Chuck-Wang/Age-of-Ultrasound/README.md

# Age-of-Ultrasound
Our challenge is to develop a device to standardize the process of capturing and sending ultrasound data using smartphones for remote diagnostics and digital record in low resource countries.
