Chuck-Wang/Age-of-Ultrasound/CAD Models/framespv2.stl

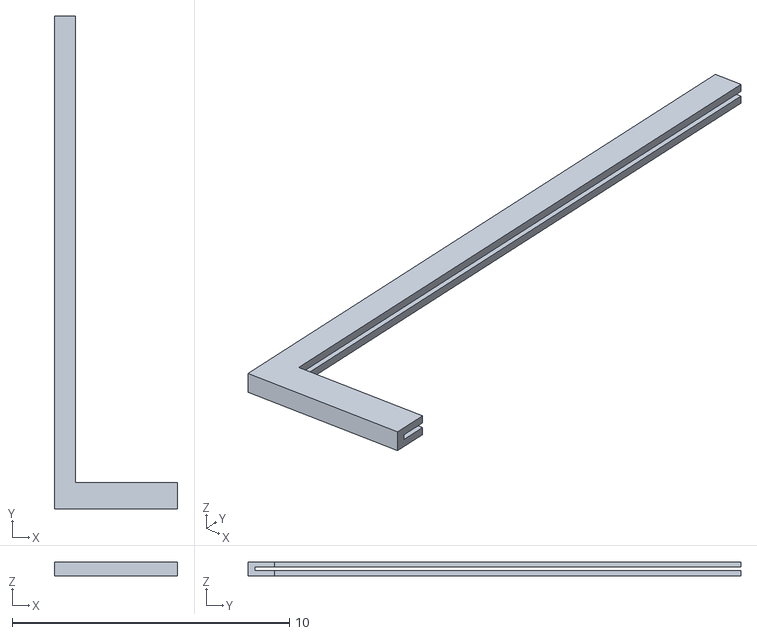
[picture p33: CAD file, 2017-11-28]
CAD Models/framespv2.stl
4.45 x 17.8 x 0.508
