Chuck-Wang/Age-of-Ultrasound/CAD Models/fixforbroken2.stl

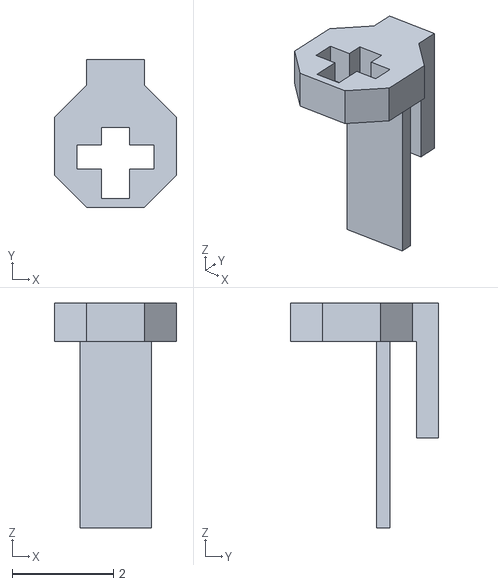
[picture p34: CAD file, 2017-11-28]
CAD Models/fixforbroken2.stl
2.41 x 2.92 x 4.44
