Chuck-Wang/Age-of-Ultrasound/CAD Models/horizontalclamppiece.stl

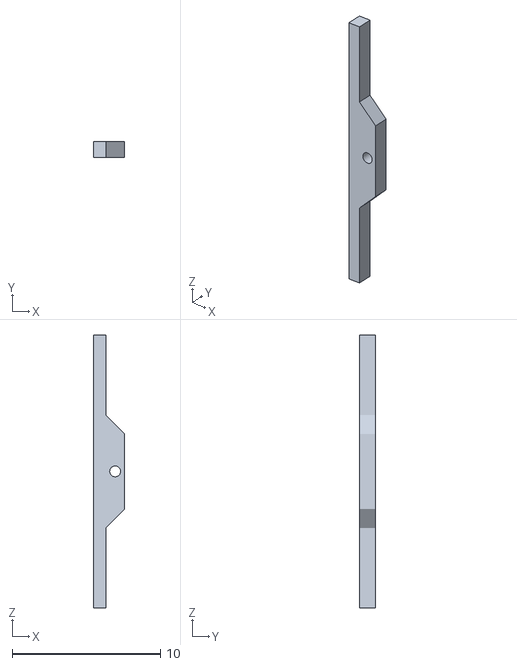
[picture p35: CAD file, 2017-11-28]
CAD Models/horizontalclamppiece.stl
2.11 x 1.07 x 18.4
