Chuck-Wang/Age-of-Ultrasound/CAD Models/horzntalconnection.stl

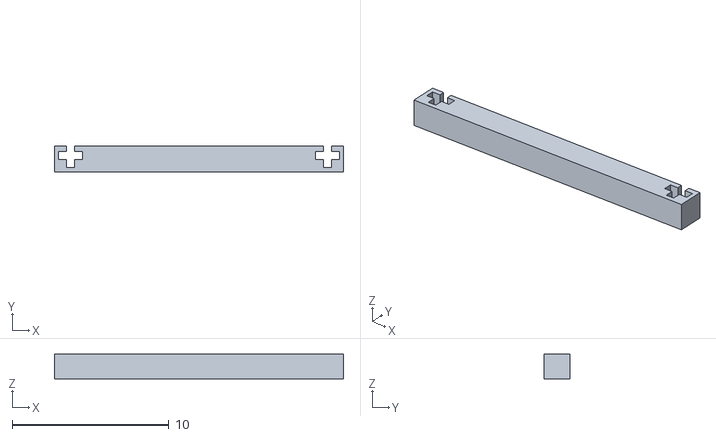
[picture p36: CAD file, 2017-11-28]
CAD Models/horzntalconnection.stl
18.4 x 1.64 x 1.59
