Chuck-Wang/Age-of-Ultrasound/CAD Models/RIPnewslideholder3.stl

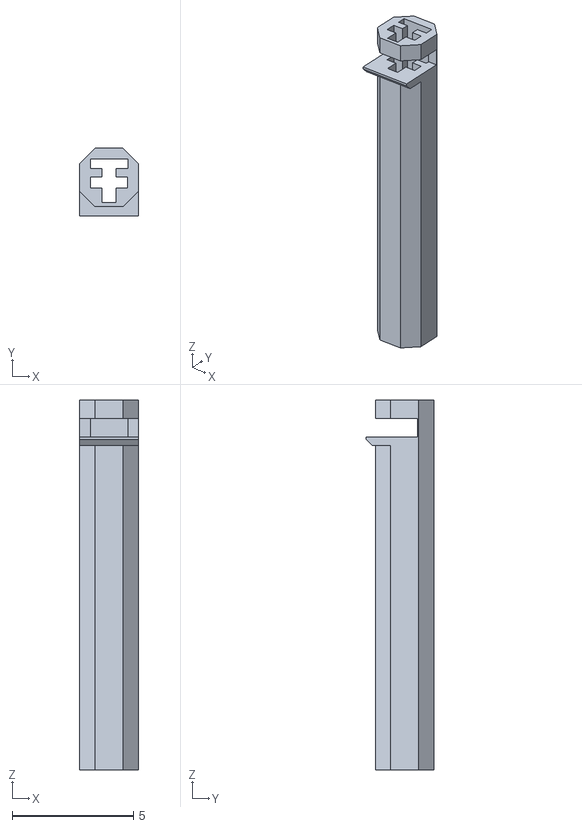
[picture p37: CAD file, 2017-11-28]
CAD Models/RIPnewslideholder3.stl
2.41 x 2.79 x 15.2
