Chuck-Wang/Age-of-Ultrasound/CAD Models/RIPnewslide3.stl

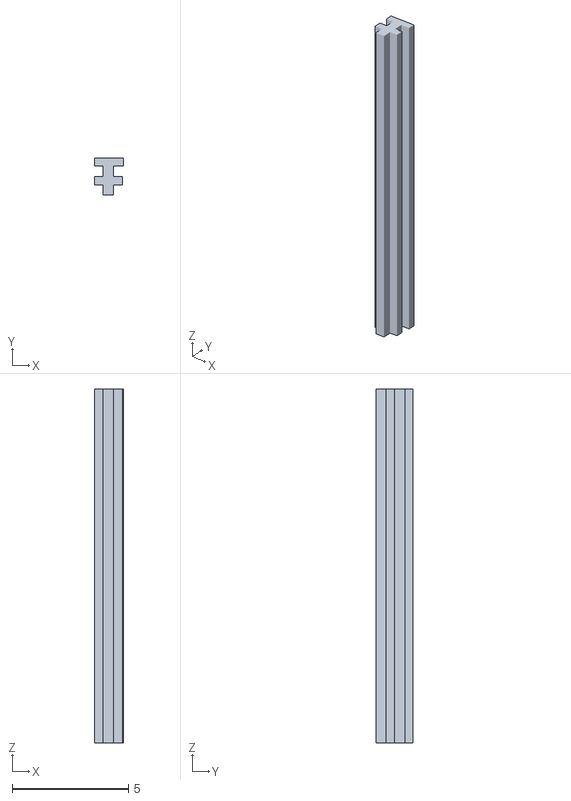
[picture p38: CAD file, 2017-11-28]
CAD Models/RIPnewslide3.stl
1.27 x 1.57 x 15.2
