Chuck-Wang/Age-of-Ultrasound/CAD Models/ripnewvertical2.stl

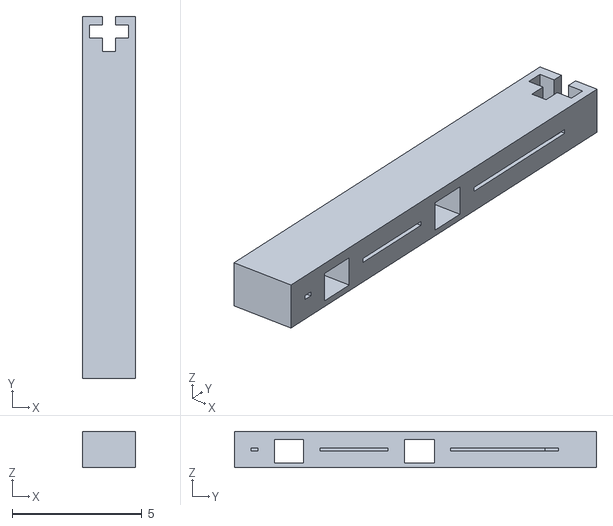
[picture p39: CAD file, 2017-11-28]
CAD Models/ripnewvertical2.stl
2.03 x 14.0 x 1.40
